MarceloMosquera/ArduinoProyecto/README.md

# ArduinoProyecto

## Componentes:

- 1 Arduino Uno
- 1 Protoboard
- 1 Green Led 
- 1 Red Led
- 1 Buzzer 
- 1 Press Button
- 1 Servo
- 2 100 ohm resistance
- 1 10 Kohm resistance

## Diagrama
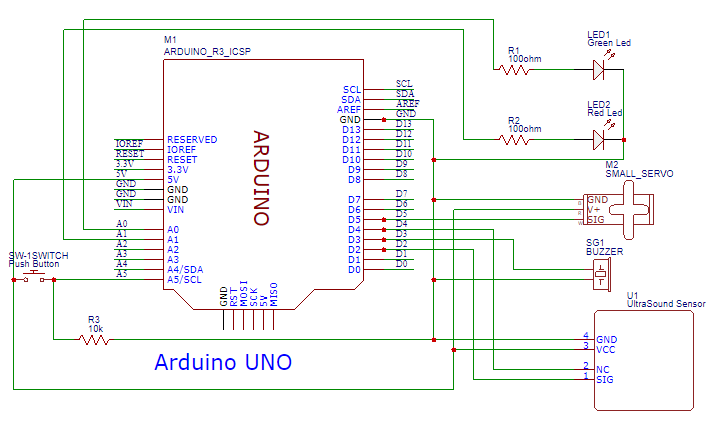
[picture p1: diagrama.png]
Diagrama


## Fotos
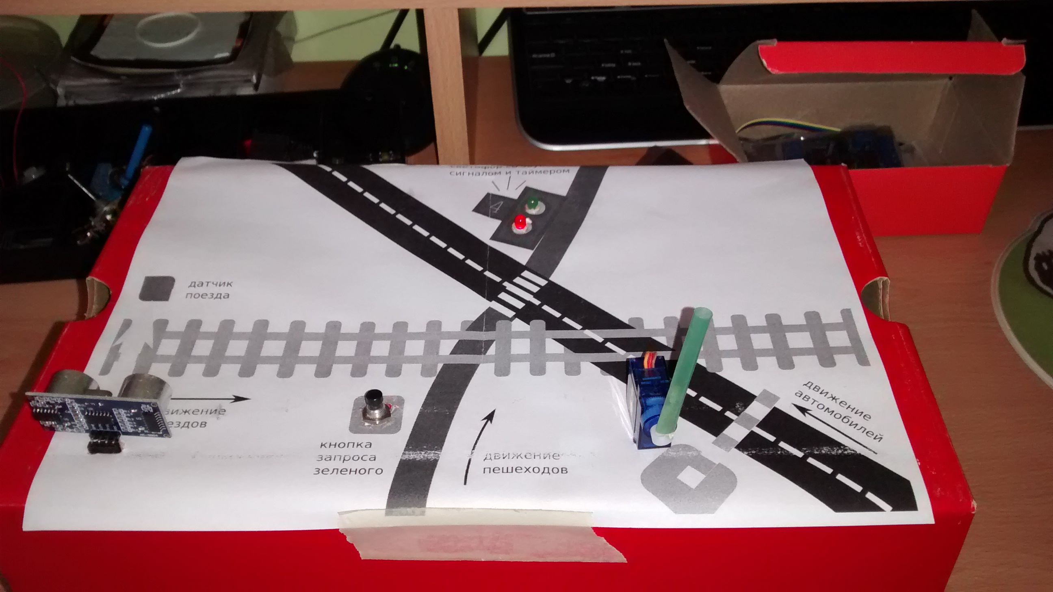
[picture p2: final-afuera.jpg]
Externo

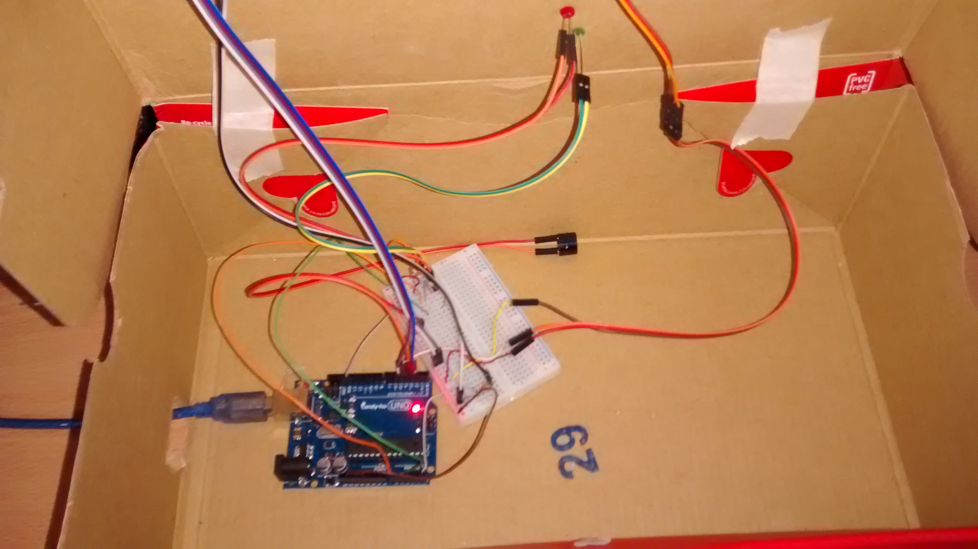
[picture p3: final-adentro.jpg]
Interno


## Video
<!-- ![Video](https://youtu.be/C5TyPwFd71U) -->
<a href="http://www.youtube.com/watch?feature=player_embedded&v=C5TyPwFd71U
" target="_blank">IMAGE ALT TEXT HERE</a>
