MarceloMosquera/ArduinoProyecto/(commit log)

2017-08-02 Added arduino-poyecto-estados.xml
2017-08-14 Mejoras en el sonido y los tiempos
2017-08-19 Cambio de altura en la barrera
2017-12-21 cambio en el doc
